msinger/iceboy/doc/test_results.html

# Blargg Test Results

https://github.com/retrio/gb-test-roms

Test | DMG-CPU B +EverDrive | IceBoy 965ada7 | Date
halt_bug | PASS | FAIL | 2018-10-31
instr_timing | PASS | FAIL | 2018-10-31
interrupt_time | FAIL | FAIL | 2018-10-31
cpu_instrs/01-special | PASS | PASS | 2018-10-31
cpu_instrs/02-interrupts | PASS | PASS | 2018-10-31
cpu_instrs/03-op sp,hl | PASS | PASS | 2018-10-31
cpu_instrs/04-op r,imm | PASS | PASS | 2018-10-31
cpu_instrs/05-op rp | PASS | PASS | 2018-10-31
cpu_instrs/06-ld r,r | PASS | PASS | 2018-10-31
cpu_instrs/07-jr,jp,call,ret,rst | PASS | PASS | 2018-10-31
cpu_instrs/08-misc instrs | PASS | PASS | 2018-10-31
cpu_instrs/09-op r,r | PASS | PASS | 2018-10-31
cpu_instrs/10-bit ops | PASS | PASS | 2018-10-31
cpu_instrs/11-op a,(hl) | PASS | PASS | 2018-10-31
dmg_sound/01-registers | PASS | PASS | 2018-10-31
dmg_sound/02-len ctr | PASS | FAIL | 2018-10-31
dmg_sound/03-trigger | PASS | FAIL | 2018-10-31
dmg_sound/04-sweep | PASS | FAIL | 2018-10-31
dmg_sound/05-sweep details | PASS | FAIL | 2018-10-31
dmg_sound/06-overflow on trigger | PASS | FAIL | 2018-10-31
dmg_sound/07-len sweep period sync | PASS | FAIL | 2018-10-31
dmg_sound/08-len ctr during power | PASS | FAIL | 2018-10-31
dmg_sound/09-wave read while on | PASS | FAIL | 2018-10-31
dmg_sound/10-wave trigger while on | FAIL | FAIL | 2018-10-31
dmg_sound/11-regs after power | PASS | FAIL | 2018-10-31
dmg_sound/12-wave write while on | PASS | FAIL | 2018-10-31
mem_timing/01-read_timing | PASS | PASS | 2018-10-31
mem_timing/02-write_timing | PASS | FAIL | 2018-10-31
mem_timing/03-modify_timing | PASS | FAIL | 2018-10-31
mem_timing-2/01-read_timing | PASS | PASS | 2018-10-31
mem_timing-2/02-write_timing | PASS | FAIL | 2018-10-31
mem_timing-2/03-modify_timing | PASS | FAIL | 2018-10-31
oam_bug/1-lcd_sync | PASS | PASS | 2018-10-31
oam_bug/2-causes | PASS | FAIL | 2018-10-31
oam_bug/3-non_causes | PASS | PASS | 2018-10-31
oam_bug/4-scanline_timing | PASS | FAIL | 2018-10-31
oam_bug/5-timing_bug | PASS | FAIL | 2018-10-31
oam_bug/6-timing_no_bug | PASS | PASS | 2018-10-31
oam_bug/7-timing_effect | PASS | FAIL | 2018-10-31
oam_bug/8-instr_effect | PASS | FAIL | 2018-10-31

# Mooneye GB Test Results

https://github.com/Gekkio/mooneye-gb (bd4b7c2)

Test | DMG-CPU B +EverDrive | IceBoy 965ada7 | Date
acceptance/add_sp_e_timing | PASS | PASS | 2018-10-30
acceptance/boot_div2-S | FAIL | FAIL | 2018-10-30
acceptance/boot_div-dmg0 | FAIL | FAIL | 2018-10-30
acceptance/boot_div-dmgABCmgb | PASS | FAIL | 2018-10-30
acceptance/boot_div-S | FAIL | FAIL | 2018-10-30
acceptance/boot_hwio-dmg0 | FAIL | FAIL | 2018-10-30
acceptance/boot_hwio-dmgABCmgb | PASS | PASS | 2018-10-30
acceptance/boot_hwio-S | FAIL | FAIL | 2018-10-30
acceptance/boot_regs-dmg0 | FAIL | FAIL | 2018-10-30
acceptance/boot_regs-dmgABC | PASS | PASS | 2018-10-30
acceptance/boot_regs-mgb | FAIL | FAIL | 2018-10-30
acceptance/boot_regs-sgb2 | FAIL | FAIL | 2018-10-30
acceptance/boot_regs-sgb | FAIL | FAIL | 2018-10-30
acceptance/call_cc_timing2 | PASS | PASS | 2018-10-30
acceptance/call_cc_timing | PASS | PASS | 2018-10-30
acceptance/call_timing2 | PASS | PASS | 2018-10-30
acceptance/call_timing | PASS | PASS | 2018-10-30
acceptance/di_timing-GS | PASS | FAIL | 2018-10-30
acceptance/div_timing | PASS | FAIL | 2018-10-30
acceptance/ei_sequence | PASS | PASS | 2018-10-30
acceptance/ei_timing | PASS | PASS | 2018-10-30
acceptance/halt_ime0_ei | PASS | FAIL | 2018-10-30
acceptance/halt_ime0_nointr_timing | PASS | FAIL | 2018-10-30
acceptance/halt_ime1_timing2-GS | PASS | FAIL | 2018-10-30
acceptance/halt_ime1_timing | PASS | FAIL | 2018-10-30
acceptance/if_ie_registers | PASS | PASS | 2018-10-30
acceptance/intr_timing | PASS | FAIL | 2018-10-30
acceptance/jp_cc_timing | PASS | PASS | 2018-10-30
acceptance/jp_timing | PASS | PASS | 2018-10-30
acceptance/ld_hl_sp_e_timing | PASS | PASS | 2018-10-30
acceptance/oam_dma_restart | PASS | PASS | 2018-10-30
acceptance/oam_dma_start | PASS | PASS | 2018-10-30
acceptance/oam_dma_timing | PASS | PASS | 2018-10-30
acceptance/pop_timing | PASS | FAIL | 2018-10-30
acceptance/push_timing | PASS | PASS | 2018-10-30
acceptance/rapid_di_ei | PASS | PASS | 2018-10-30
acceptance/ret_cc_timing | PASS | FAIL | 2018-10-30
acceptance/reti_intr_timing | PASS | PASS | 2018-10-30
acceptance/reti_timing | PASS | PASS | 2018-10-30
acceptance/ret_timing | PASS | PASS | 2018-10-30
acceptance/rst_timing | PASS | PASS | 2018-10-30
acceptance/bits/mem_oam | PASS | PASS | 2018-10-30
acceptance/bits/reg_f | PASS | PASS | 2018-10-30
acceptance/bits/unused_hwio-GS | PASS | PASS | 2018-10-30
acceptance/instr/daa | PASS | PASS | 2018-10-30
acceptance/interrupts/ie_push | PASS | PASS | 2018-10-30
acceptance/oam_dma/basic | PASS | PASS | 2018-10-30
acceptance/oam_dma/reg_read | PASS | FAIL | 2018-10-30
acceptance/oam_dma/sources-dmgABCmgbS | PASS | FAIL | 2018-10-30
acceptance/ppu/hblank_ly_scx_timing-GS | PASS | PASS | 2018-10-31
acceptance/ppu/intr_1_2_timing-GS | PASS | FAIL | 2018-10-31
acceptance/ppu/intr_2_0_timing | PASS | PASS | 2018-10-31
acceptance/ppu/intr_2_mode0_timing | PASS | FAIL | 2018-10-31
acceptance/ppu/intr_2_mode0_timing_sprites | PASS | FAIL | 2018-10-31
acceptance/ppu/intr_2_mode3_timing | PASS | FAIL | 2018-10-31
acceptance/ppu/intr_2_oam_ok_timing | PASS | FAIL | 2018-10-31
acceptance/ppu/lcdon_timing-dmgABCmgbS | PASS | FAIL | 2018-10-31
acceptance/ppu/lcdon_write_timing-GS | PASS | FAIL | 2018-10-31
acceptance/ppu/stat_irq_blocking | PASS | PASS | 2018-10-31
acceptance/ppu/stat_lyc_onoff | PASS | FAIL | 2018-10-31
acceptance/ppu/vblank_stat_intr-GS | PASS | FAIL | 2018-10-31
acceptance/serial/boot_sclk_align-dmgABCmgb | PASS | FAIL | 2018-10-30
acceptance/timer/div_write | PASS | PASS | 2018-10-31
acceptance/timer/rapid_toggle | PASS | PASS | 2018-10-31
acceptance/timer/tim00_div_trigger | PASS | PASS | 2018-10-31
acceptance/timer/tim00 | PASS | FAIL | 2018-10-31
acceptance/timer/tim01_div_trigger | PASS | FAIL | 2018-10-31
acceptance/timer/tim01 | PASS | FAIL | 2018-10-31
acceptance/timer/tim10_div_trigger | PASS | FAIL | 2018-10-31
acceptance/timer/tim10 | PASS | FAIL | 2018-10-31
acceptance/timer/tim11_div_trigger | PASS | PASS | 2018-10-31
acceptance/timer/tim11 | PASS | FAIL | 2018-10-31
acceptance/timer/tima_reload | PASS | FAIL | 2018-10-31
acceptance/timer/tima_write_reloading | PASS | FAIL | 2018-10-31
acceptance/timer/tma_write_reloading | PASS | PASS | 2018-10-31
emulator-only/bits_ram_en | FAIL | FAIL | 2018-10-31
emulator-only/multicart_rom_8Mb | FAIL | FAIL | 2018-10-31
emulator-only/ram_256Kb | FAIL | FAIL | 2018-10-31
emulator-only/ram_64Kb | FAIL | FAIL | 2018-10-31
emulator-only/rom_16Mb | FAIL | FAIL | 2018-10-31
emulator-only/rom_1Mb | PASS | FAIL | 2018-10-31
emulator-only/rom_2Mb | PASS | FAIL | 2018-10-31
emulator-only/rom_4Mb | PASS | FAIL | 2018-10-31
emulator-only/rom_512Kb | PASS | FAIL | 2018-10-31
emulator-only/rom_8Mb | FAIL | FAIL | 2018-10-31
madness/mgb_oam_dma_halt_sprites | PASS | FAIL | 2018-10-31
manual-only/sprite_priority | PASS | PASS | 2018-10-31
