msinger/iceboy/pcbs/hx8k_brk_mem/hx8k_brk_mem.kicad_pcb

## KiCad design pcbs/hx8k_brk_mem/hx8k_brk_mem.kicad_pcb (2024-06-20)

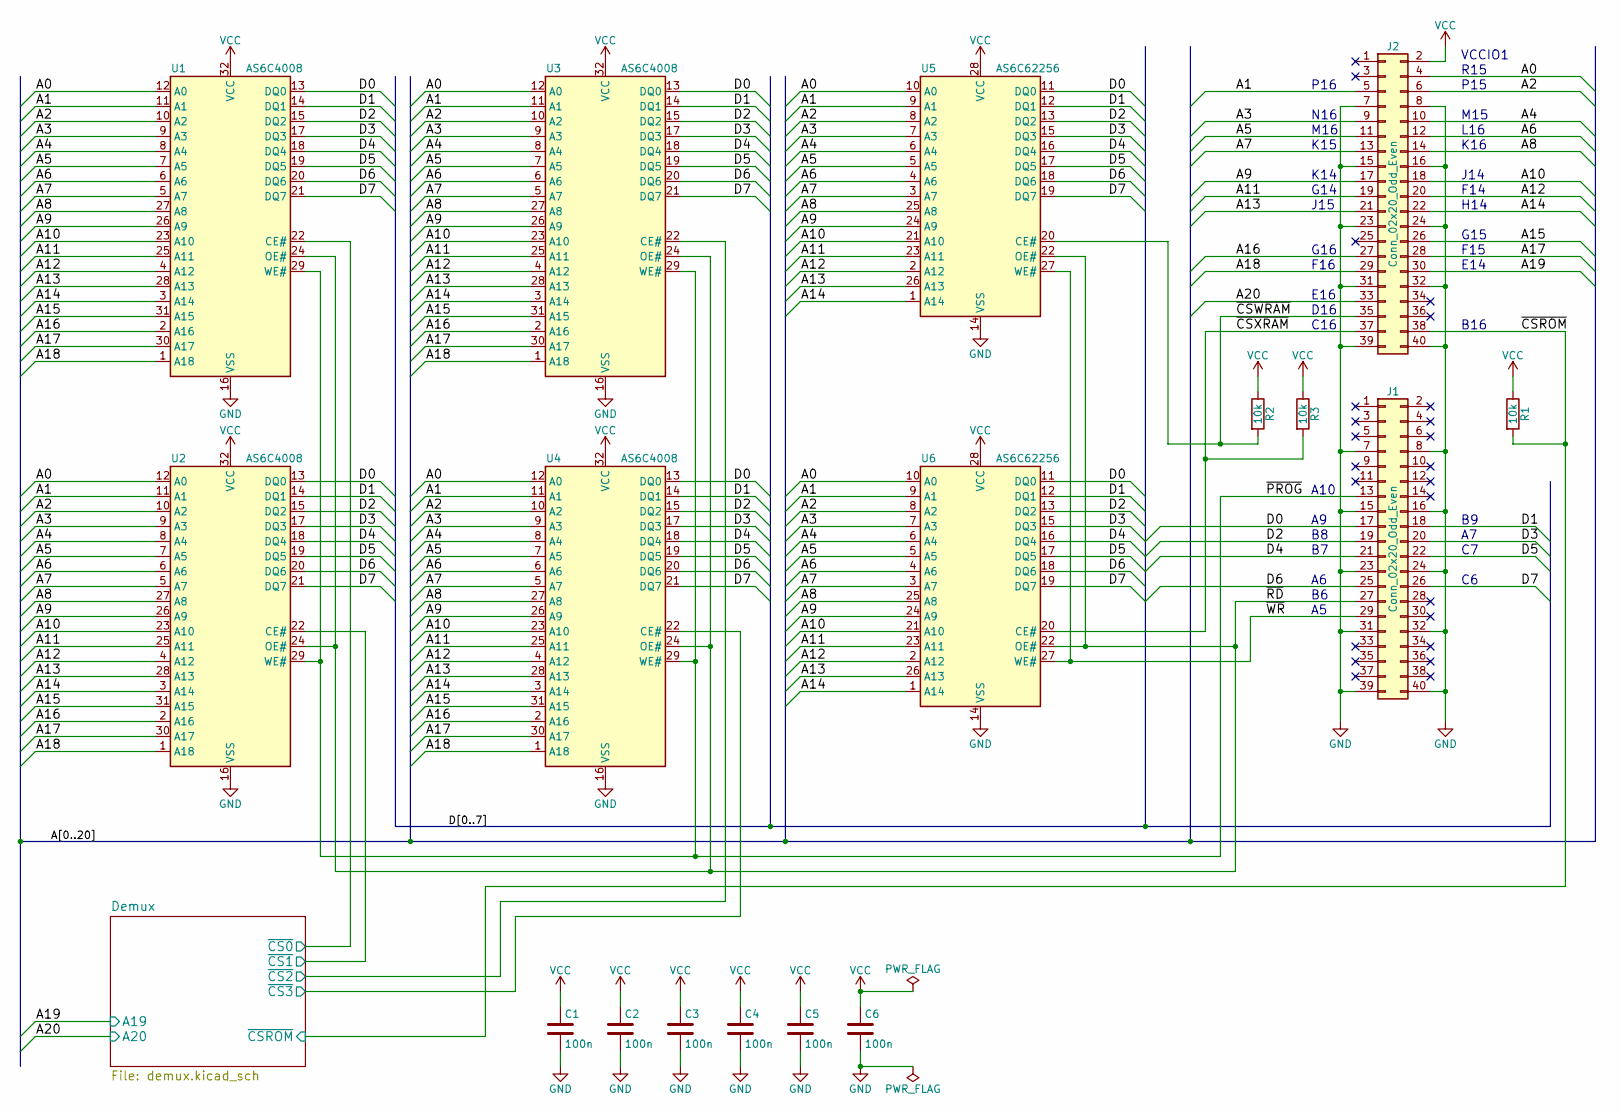
[picture p1: schematic hx8k_brk_mem.kicad_sch, Iceboy HX8K-BRK Memory Module]

Parts:
C1, C2, C3, C4, C5, C6: 100n; C_Disc_D3.0mm_W2.0mm_P2.50mm
J1, J2: Conn_02x20_Odd_Even; PinSocket_2x20_P2.54mm_Vertical
R1, R2, R3: 10k; R_Axial_DIN0207_L6.3mm_D2.5mm_P10.16mm_Horizontal
U1, U2, U3, U4: AS6C4008; DIP-32_W15.24mm_Socket
U5, U6: AS6C62256; DIP-28_W15.24mm_Socket

Connections:
/A0: J2.4, U1.12 (A0), U2.12 (A0), U3.12 (A0), U4.12 (A0), U5.10 (A0), U6.10 (A0)
/A1: J2.5, U1.11 (A1), U2.11 (A1), U3.11 (A1), U4.11 (A1), U5.9 (A1), U6.9 (A1)
/A2: J2.6, U1.10 (A2), U2.10 (A2), U3.10 (A2), U4.10 (A2), U5.8 (A2), U6.8 (A2)
/A3: J2.9, U1.9 (A3), U2.9 (A3), U3.9 (A3), U4.9 (A3), U5.7 (A3), U6.7 (A3)
/A4: J2.10, U1.8 (A4), U2.8 (A4), U3.8 (A4), U4.8 (A4), U5.6 (A4), U6.6 (A4)
/A5: J2.11, U1.7 (A5), U2.7 (A5), U3.7 (A5), U4.7 (A5), U5.5 (A5), U6.5 (A5)
/A6: J2.12, U1.6 (A6), U2.6 (A6), U3.6 (A6), U4.6 (A6), U5.4 (A6), U6.4 (A6)
/A7: J2.13, U1.5 (A7), U2.5 (A7), U3.5 (A7), U4.5 (A7), U5.3 (A7), U6.3 (A7)
/A8: J2.14, U1.27 (A8), U2.27 (A8), U3.27 (A8), U4.27 (A8), U5.25 (A8), U6.25 (A8)
/A9: J2.17, U1.26 (A9), U2.26 (A9), U3.26 (A9), U4.26 (A9), U5.24 (A9), U6.24 (A9)
/A10: J2.18, U1.23 (A10), U2.23 (A10), U3.23 (A10), U4.23 (A10), U5.21 (A10), U6.21 (A10)
/A11: J2.19, U1.25 (A11), U2.25 (A11), U3.25 (A11), U4.25 (A11), U5.23 (A11), U6.23 (A11)
/A12: J2.20, U1.4 (A12), U2.4 (A12), U3.4 (A12), U4.4 (A12), U5.2 (A12), U6.2 (A12)
/A13: J2.21, U1.28 (A13), U2.28 (A13), U3.28 (A13), U4.28 (A13), U5.26 (A13), U6.26 (A13)
/A14: J2.22, U1.3 (A14), U2.3 (A14), U3.3 (A14), U4.3 (A14), U5.1 (A14), U6.1 (A14)
/A15: J2.26, U1.31 (A15), U2.31 (A15), U3.31 (A15), U4.31 (A15)
/A16: J2.27, U1.2 (A16), U2.2 (A16), U3.2 (A16), U4.2 (A16)
/A17: J2.28, U1.30 (A17), U2.30 (A17), U3.30 (A17), U4.30 (A17)
/A18: J2.29, U1.1 (A18), U2.1 (A18), U3.1 (A18), U4.1 (A18)
/A19: J2.30; also elsewhere on the board
/A20: J2.33; also elsewhere on the board
/D0: J1.17, U1.13 (DQ0), U2.13 (DQ0), U3.13 (DQ0), U4.13 (DQ0), U5.11 (DQ0), U6.11 (DQ0)
/D1: J1.18, U1.14 (DQ1), U2.14 (DQ1), U3.14 (DQ1), U4.14 (DQ1), U5.12 (DQ1), U6.12 (DQ1)
/D2: J1.19, U1.15 (DQ2), U2.15 (DQ2), U3.15 (DQ2), U4.15 (DQ2), U5.13 (DQ2), U6.13 (DQ2)
/D3: J1.20, U1.17 (DQ3), U2.17 (DQ3), U3.17 (DQ3), U4.17 (DQ3), U5.15 (DQ3), U6.15 (DQ3)
/D4: J1.21, U1.18 (DQ4), U2.18 (DQ4), U3.18 (DQ4), U4.18 (DQ4), U5.16 (DQ4), U6.16 (DQ4)
/D5: J1.22, U1.19 (DQ5), U2.19 (DQ5), U3.19 (DQ5), U4.19 (DQ5), U5.17 (DQ5), U6.17 (DQ5)
/D6: J1.25, U1.20 (DQ6), U2.20 (DQ6), U3.20 (DQ6), U4.20 (DQ6), U5.18 (DQ6), U6.18 (DQ6)
/D7: J1.26, U1.21 (DQ7), U2.21 (DQ7), U3.21 (DQ7), U4.21 (DQ7), U5.19 (DQ7), U6.19 (DQ7)
/Demux/~CS0: U1.22 (CE#); also elsewhere on the board
/Demux/~CS1: U2.22 (CE#); also elsewhere on the board
/Demux/~CS2: U3.22 (CE#); also elsewhere on the board
/Demux/~CS3: U4.22 (CE#); also elsewhere on the board
/~CSROM: J2.38, R1.2; also elsewhere on the board
/~CSWRAM: J2.35, R2.2, U5.20 (CE#)
/~CSXRAM: J2.37, R3.2, U6.20 (CE#)
/~PROG: J1.13, U1.29 (WE#), U2.29 (WE#), U3.29 (WE#), U4.29 (WE#)
/~RD: J1.27, U1.24 (OE#), U2.24 (OE#), U3.24 (OE#), U4.24 (OE#), U5.22 (OE#), U6.22 (OE#)
/~WR: J1.29, U5.27 (WE#), U6.27 (WE#)
GND: C1.2, C2.2, C3.2, C4.2, C5.2, C6.2, J1.7, J1.8, J1.15, J1.16, J1.23, J1.24, J1.31, J1.32, J1.39, J1.40, J2.7, J2.8, J2.15, J2.16, J2.23, J2.24, J2.31, J2.32, J2.39, J2.40, U1.16 (VSS), U2.16 (VSS), U3.16 (VSS), U4.16 (VSS), U5.14 (VSS), U6.14 (VSS); also elsewhere on the board
VCC: C1.1, C2.1, C3.1, C4.1, C5.1, C6.1, J2.2, R1.1, R2.1, R3.1, U1.32 (VCC), U2.32 (VCC), U3.32 (VCC), U4.32 (VCC), U5.28 (VCC), U6.28 (VCC); also elsewhere on the board

Notes on the sheet:
E16
P16
VCCIO1
M15
L16
N16
C16
G16
F16
K16
F15
G14
A10
K15
D16
F14
J15
G15
J14
E14
B16
R15
K14
M16
H14
P15

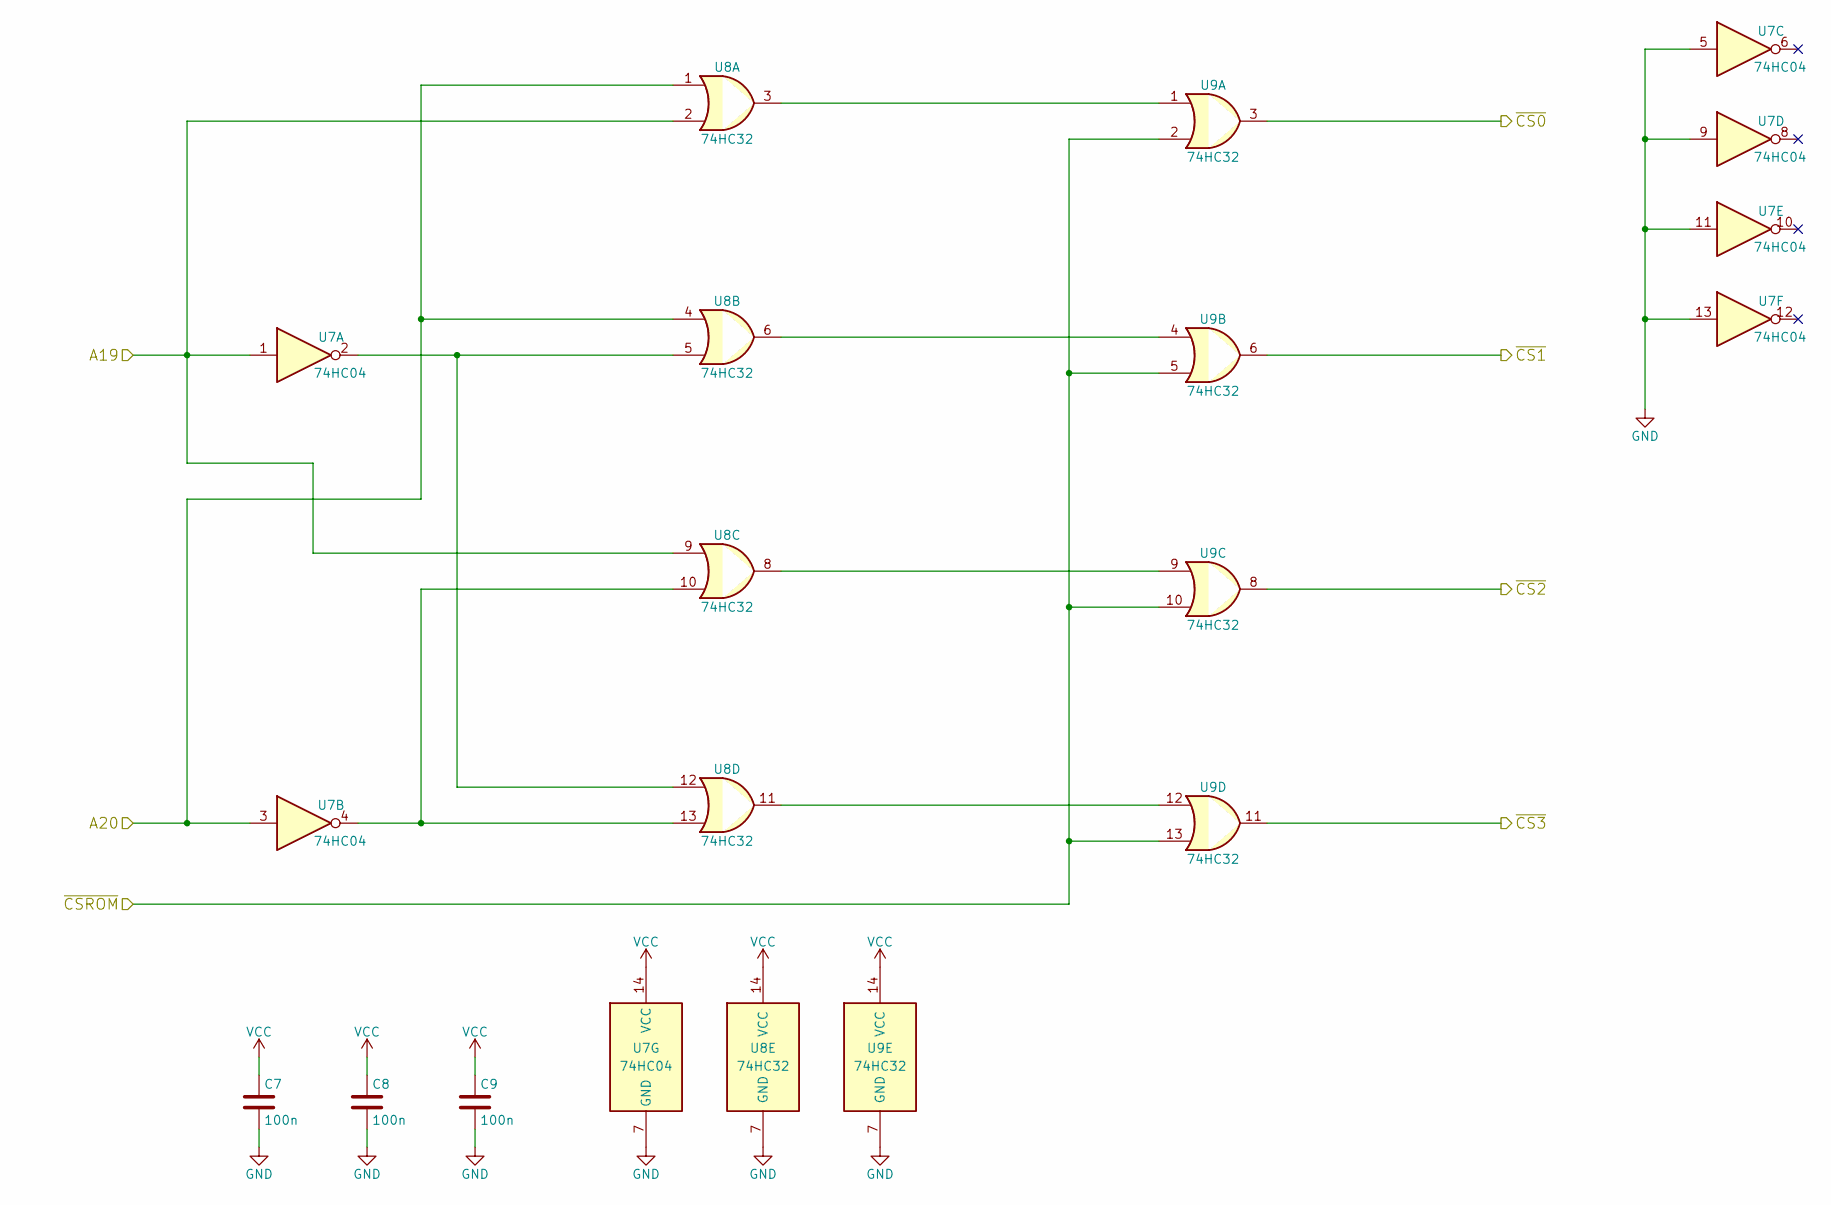
[picture p2: schematic demux.kicad_sch, Iceboy HX8K-BRK Memory Module]

Parts:
C7, C8, C9: 100n; C_Disc_D3.0mm_W2.0mm_P2.50mm
U7: 74HC04; DIP-14_W7.62mm_Socket
U8, U9: 74HC32; DIP-14_W7.62mm_Socket

Connections:
/A19: U7.1, U8.2, U8.9; also elsewhere on the board
/A20: U7.3, U8.1, U8.4; also elsewhere on the board
/Demux/~CS0: U9.3; also elsewhere on the board
/Demux/~CS1: U9.6; also elsewhere on the board
/Demux/~CS2: U9.8; also elsewhere on the board
/Demux/~CS3: U9.11; also elsewhere on the board
/~CSROM: U9.2, U9.5, U9.10, U9.13; also elsewhere on the board
GND: C7.2, C8.2, C9.2, U7.5, U7.7 (GND), U7.9, U7.11, U7.13, U8.7 (GND), U9.7 (GND); also elsewhere on the board
unnamed: U7.2, U8.5, U8.12
unnamed: U7.4, U8.10, U8.13
unnamed: U8.3, U9.1
unnamed: U8.6, U9.4
unnamed: U8.8, U9.9
unnamed: U8.11, U9.12
VCC: C7.1, C8.1, C9.1, U7.14 (VCC), U8.14 (VCC), U9.14 (VCC); also elsewhere on the board

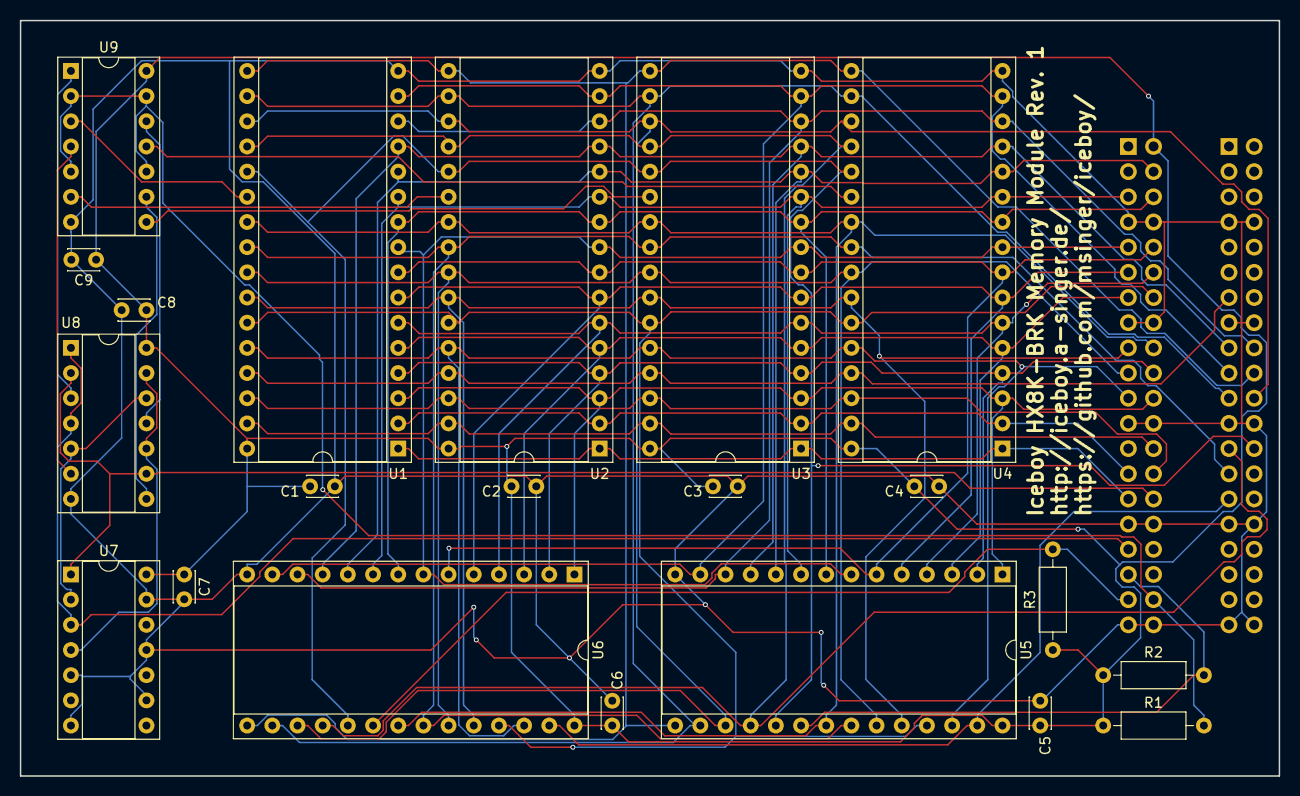
[picture p3: board hx8k_brk_mem.kicad_pcb from above]

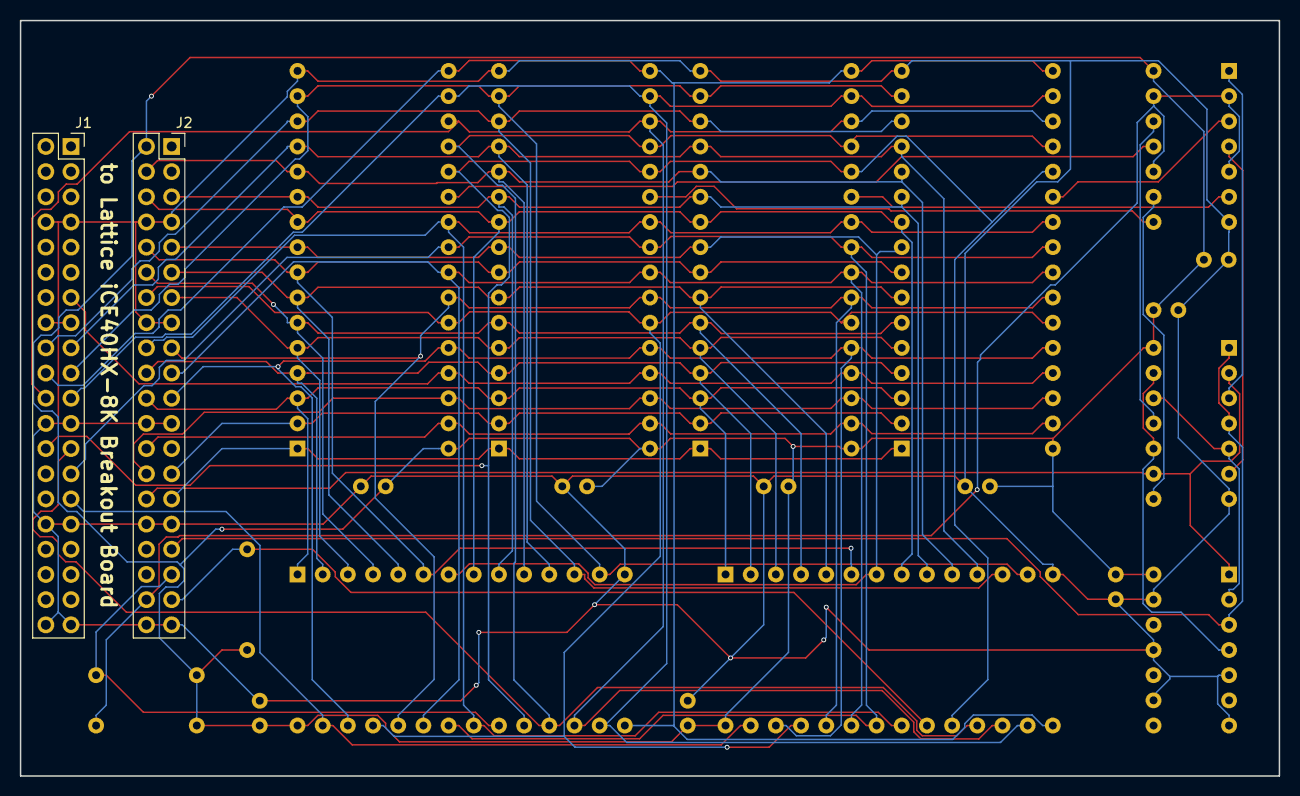
[picture p4: board hx8k_brk_mem.kicad_pcb from below]

Board: 2 copper layers, 127.0 x 76.2 mm, 23 parts (2 on the bottom side), 47 nets.
