msinger/iceboy/src/gameboy.pcf

# For the iCE40HX-8K Breakout Board

# LEDs
set_io led[0]    C3
set_io led[1]    B3
set_io led[2]    C4
set_io led[3]    C5
set_io led[4]    A1
set_io led[5]    A2
set_io led[6]    B4
set_io led[7]    B5

# Ext. Address Bus
set_io adr[0]    R15
set_io adr[1]    P16
set_io adr[2]    P15
set_io adr[3]    N16
set_io adr[4]    M15
set_io adr[5]    M16
set_io adr[6]    L16
set_io adr[7]    K15
set_io adr[8]    K16
set_io adr[9]    K14
set_io adr[10]   J14
set_io adr[11]   G14
set_io adr[12]   F14
set_io adr[13]   J15
set_io adr[14]   H14
set_io adr[15]   G15
set_io adr[16]   G16
set_io adr[17]   F15
set_io adr[18]   F16
set_io adr[19]   E14
set_io adr[20]   E16

# Ext. Data Bus
set_io data[0]   A9
set_io data[1]   B9
set_io data[2]   B8
set_io data[3]   A7
set_io data[4]   B7
set_io data[5]   C7
set_io data[6]   A6
set_io data[7]   C6

# Ext. R/W
set_io n_read    B6
set_io n_write   A5

# Ext. Chip Selects
set_io n_cs_ram  D16
set_io n_cs_cart D14
set_io n_cs_crom B16
set_io n_cs_cram C16

# Clock & Reset
set_io clk12m    J3
set_io n_reset   D15

# Config
set_io n_emu_mbc A11

# Debugger & Prog Loader
set_io rx        B10
set_io tx        B12
set_io cts       A15

# Audio PWMs
set_io chl       T1
set_io chr       T2
set_io chm       T3

# Joypad
set_io p10       R6
set_io p11       T5
set_io p12       R5
set_io p13       R3
set_io p14       R4
set_io p15       R2

# LCD Data Bus
set_io lcd_data[0] T15
set_io lcd_data[1] T16
set_io lcd_data[2] T13
set_io lcd_data[3] T14
set_io lcd_data[4] N12
set_io lcd_data[5] P13
set_io lcd_data[6] N10
set_io lcd_data[7] M11

# LCD R/W, Chip Select, C/D, Backlight
set_io n_lcd_rd    P10
set_io n_lcd_wr    T10
set_io n_lcd_cs    T11
set_io lcd_cd      R10
set_io lcd_vled    P8
