msinger/iceboy/src/lr35902_map.sv

`default_nettype none

(* nolatches *)
module lr35902_map(
		input  logic        reset,

		input  logic [15:0] adr,
		input  logic        enable_bootrom,

		output logic        cs_brom,
		output logic        cs_rom,
		output logic        cs_xram,
		output logic        cs_vram,
		output logic        cs_wram,
		output logic        cs_oam,
		output logic        cs_io,
	);

	always_comb begin
		cs_brom = 0;
		cs_rom  = 0;
		cs_xram = 0;
		cs_vram = 0;
		cs_wram = 0;
		cs_oam  = 0;
		cs_io   = 0;

		if (!reset) casez ({ enable_bootrom, adr })
		/* B A15....A8 A7.....A0 */
		'b 1_0000_0000_????_????: /* 0x0000-0x00ff: 256 byte BOOT ROM (if enabled) */
			cs_brom = 1;
		'b ?_00??_????_????_????, /* 0x0000-0x3fff: 16k cartridge ROM bank #0 */
		'b ?_01??_????_????_????: /* 0x4000-0x7fff: 16k switchable cartridge ROM bank #1..#127 */
			cs_rom = 1;
		'b ?_101?_????_????_????: /* 0xa000-0xbfff: 8k switchable cartridge RAM bank #0..#15 */
			cs_xram = 1;
		'b ?_100?_????_????_????: /* 0x8000-0x9fff: 8k video RAM */
			cs_vram = 1;
		'b ?_1111_1110_????_????: /* 0xfe00-0xfeff: OAM (object attribute memory) */
			cs_oam = 1;
		'b ?_1111_1111_????_????: /* 0xff00-0xffff: I/O registers */
			cs_io = 1;
		'b ?_110?_????_????_????, /* 0xc000-0xdfff: 8k RAM */
		'b ?_111?_????_????_????: /* 0xe000-0xfdff: 8k RAM (repeated; partially shadowed by I/O registers) */
			cs_wram = 1;
		endcase
	end
endmodule
