msinger/iceboy/tests/cpu/ld16/ld_sp_hl.sv

`default_nettype none

(* nolatches *)
module testbench(input logic clk);
	`include "cpu.svh"

	/* Choose "LD SP, HL" opcode */
	logic [7:0] instr = 'hf9; /* LD SP, HL */
	always_comb unique case (cyc)
		din_idx(1): din = instr;
		default:    din = $anyseq;
	endcase

	/* PC must not change during M2 cycle */
	always_ff @(posedge clk) if (cyc > mt_idx(2, 1) && cyc <= mt_idx(3, 1)) begin
		assert ($stable(reg_pc));
	end

	/* General purpose registers must not change after the first M1 cycle */
	always_ff @(posedge clk) if (cyc > mt_idx(1, 4) && cyc <= mt_idx(3, 4)) begin
		assert ($stable(reg_bc));
		assert ($stable(reg_de));
		assert ($stable(reg_hl));
		assert ($stable(reg_af));
	end

	/* Value of HL and SP must be equal after the instruction */
	always_comb if (cyc == mt_idx(3, 4)) assert (reg_hl == reg_sp);

	/* Check addresses used for reading */
	always_ff @(posedge clk) assert_mcyc_adr(3, reg_pc, 2); /* PC at M2T1 must be used for loading next instruction */
endmodule
