msinger/iceboy/(commit log)

2018-01-27 implement relative jumps; fix bus timings
    [bootrom.v, lr35902.v, map.v, mbc.v, vram.v]
2018-02-10 LCD blew up -- fuck it -- look for another one
    [gameboy.pcf]
2018-02-19 small fixes and PLL
    [lr35902.v]
2018-02-26 fix conditional relative jumps
    [lr35902.v]
2018-03-11 split bus for DMA
2018-03-18 allow dbg uart and prog uart to coexist
2018-03-18 fix 16 bit inc/dec
    [lr35902.v]
2018-03-23 implement interrupt entry & return
2018-03-24 implement timer counter ff05-ff07
2018-03-26 implement PWMs for sound output
2018-04-02 move PPU stuff to second device
2018-04-03 add kicad schematics
    [amp.kicad_pcb, amp.sch, memory.kicad_pcb, memory.sch]
2018-04-05 reset sound registers when master_ena==0
    [lr35902_snd.v]
2018-04-16 some tiles display correctly
    [lcd_uc1611.v]
2018-04-18 fix PPU FIFO direction: shift out MSB
    [lr35902_ppu.v]
2018-04-18 fix lcd pixel output
    [lcd_uc1611.v]
2018-04-23 fix glitchy wires
2018-04-27 fixed carry flags of 16bit instructions
    [lr35902.v]
2018-04-27 fix stack pointer decrement for RST
    [lr35902.v]
2018-04-27 fix RES & SET for (HL)
    [lr35902.v]
2018-04-27 fix RL & RR for (HL)
    [lr35902.v]
2018-04-29 fix nonreadable bits in sound registers
    [lr35902_snd.v]
2018-04-30 fix timer
    * DIV reset prevents TIMA increments
    * toggling TIMA enable can trigger TIMA increments
2018-04-30 fix window X pos
    should also cause the glitch that happens on the real DMG if WX<7
    [lr35902_ppu.v]
2018-05-05 implement OAM DMA
2018-05-06 fix OAM DMA timing
2018-05-07 tried fixing timer timing
2018-05-11 clear OAM on reset
    [lr35902_oam.v]
2018-12-09 switch to nextpnr
2019-03-03 remove unused wires
2019-03-04 hack for passing MBC1 tests
    Tests that check if CPU reads 0xff from cartridge memory when SRAM is
    disabled in MBC fail. Maybe because the pull-up resistors are too
    weak. This commit is a temporary fix for that.
    Also needed to remove n_emu_mbc pin. Arachne and nextpnr where not able
    to route anymore.
2019-03-31 make top.v board specific
2019-03-31 basic support for gbreveng board
2019-03-31 UART support for gbreveng board
2019-03-31 fix undefined WRAM address lines
    [gbreveng-top.v, hx8k_brk-top.v]
2019-03-31 support onboard RAMs on gbreveng board
    - WRAM
    - onboard cartridge ROM
    - onboard cartridge RAM
2019-03-31 implement bi-directional reset pin on cart. slot
2019-03-31 output 1 MiHz clock on cartridge slot
2019-03-31 disable pull-ups on reset and emu_mbc pins
    they have external pull-downs
    [gbreveng-top.v]
2019-03-31 generate !OE and DIR signals for cart. slot
2019-04-03 use 16 MiHz clock
    Now synchronization between clock domains is an issue. Debugger won't
    work anymore.
    [gbreveng-top.v]
2019-04-03 don't use PLL on gbreveng board
2019-04-05 sync clock domains for debug uart
2019-04-06 make gbreveng board the default
2019-04-06 fix clock sync for prog_loader on hx8k_brk
    [gbreveng-top.v, hx8k_brk-top.v]
2019-10-13 original LH507x LCD row&column drivers working
    Need to rewrite parts of UC1611 LCD driver now to
    make it work with the modified PPU signals.
2019-10-13 UC1611 LCD driver now works with new PPU signals
2019-10-13 fix UC1611 LCD driver
    [lcd_uc1611.v]
2019-10-14 fix UC1611 LCD driver
    Lines were offset by one and last two lines were repeated as garbage at
    the end of the picture.
    rd_pxcnt needed to be sampled one tick later. It still had the previous
    value.
    [lcd_uc1611.v]
2019-10-26 extract UART from loader and debugger into module
2019-10-28 fix clock domain crossings for UART
    no magic delays anymore
    [gbreveng-top.v, hx8k_brk-top.v]
2019-10-29 implement lock/unlock sequences for debugger
    When using FT245 interface, debugger always receives 0x00 (HALT) command
    directly after plugging in USB to a host controller. This is probably
    sent by some driver, because it does not happen when plugging into a USB
    power adapter or power bank.
    Now debugger is 'locked' on startup. All state-changing commands are
    inaccessible until an unlock sequence was received.
2019-11-03 fix clock domain crossings
    [bootrom.v, dom_gate.v, gbreveng-top.v, hx8k_brk-top.v, lr35902.v, lr35902_joy.v, lr35902_oam.v, lr35902_ppu.v]
2019-11-08 fix pin name
2020-04-10 fix underscores in number literals
    [lr35902_iomap.v, lr35902_map.v, lr35902_ppu.v]
2020-04-27 add kicad project for memory pcb
    [demux.sch, hx8k_brk_mem.kicad_pcb, hx8k_brk_mem.sch]
2020-09-06 fix usage comment for ALU
    [sm83_alu.sv]
2020-09-14 fix usage comment for ALU bit operations
    [sm83_alu.sv]
2021-01-04 fix ppu tasks for new yosys version
    [lr35902_ppu.v]
2021-01-17 reworked ALU based on A-Z80 circuit
    [sm83_alu.sv, sm83_alu_control.sv, sm83_alu_flags.sv]
2021-02-21 SM83: Fix LD (HL), n
    [sm83_io.sv]
2021-02-21 SM83: Fix data out timing
    [sm83_control.sv, sm83_io.sv]
2021-02-21 SM83: Fix "LD A, (BC)" and "LD A, (DE)"
    [sm83_control.sv]
2021-02-21 SM83: Disallow interrupts after CB prefix
2021-02-21 SM83: Fix "LD (nn), SP" instruction
    [sm83_control.sv]
2021-02-21 SM83: Fix zero flag for LDHL and "ADD SP, e"
    [sm83.sv, sm83_alu_flags.sv, sm83_control.sv]
2021-02-21 SM83: Fix carry logic for SUB, SBC and CP
    [sm83_control.sv]
2021-02-21 SM83: Fix carry after DAA
    [sm83.sv, sm83_alu_flags.sv, sm83_control.sv]
2021-02-21 SM83: Rework control structure
    [sm83_control.sv]
2021-02-21 SM83: Fix unique case uniqueness
    [sm83_control.sv]
2021-02-21 SM83: Fix RST opcodes
    [sm83_decode.sv]
2021-02-21 SM83: Fix 8 bit inc/dec
    [sm83_control.sv]
2021-02-21 SM83: Implement SWAP instruction
    [sm83_control.sv]
2021-02-21 SM83: Fix high nibble result of "ADD SP, e"
    [sm83_control.sv]
2021-02-21 SM83: Fix relative jumps duplicating high byte
    [sm83_control.sv]
2021-02-21 SM83: Fix cond. call/return instructions
    [sm83_control.sv]
2021-02-21 SM83: Fix carry output of SRA
    [sm83_control.sv]
2021-03-07 SM83: Fix logic loops detected by new yosys
    [sm83.sv, sm83_adr_inc.sv, sm83_control.sv, sm83_dbg_ifc_sim.cc, sm83_dbg_ifc_sim.sv, sm83_decode.sv, sm83_io.sv, sm83_sequencer.sv]
2021-03-14 Fix debug ifc simulation
    [sm83_dbg_ifc.sv, sm83_dbg_ifc_sim.cc, sm83_dbg_ifc_sim.sv]
2021-03-14 SM83: Fix debug interface for new CPU
    [sm83.sv, sm83_control.sv, sm83_dbg_ifc.sv, sm83_dbg_ifc_sim.cc, sm83_dbg_ifc_sim.sv]
2021-08-18 Switch to CERN-OHL-W v2 license
2024-06-20 Migrate memory pcb from KiCad 4 to KiCad 8
    [demux.kicad_sch, demux.sch, hx8k_brk_mem.kicad_pcb, hx8k_brk_mem.kicad_sch, hx8k_brk_mem.sch]
2025-03-29 Ignore *.kicad_prl
